HydrogreenPollub/fuel-cell-pcb/schematic-main.jpg

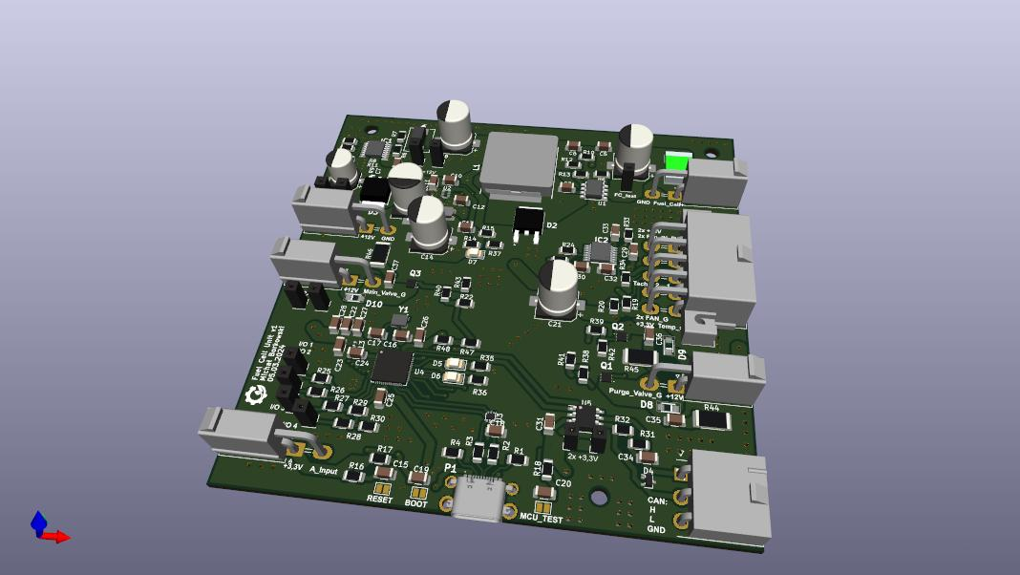
schematic-main.jpg
