HydrogreenPollub/fuel-cell-pcb/schematic-main 2.jpg

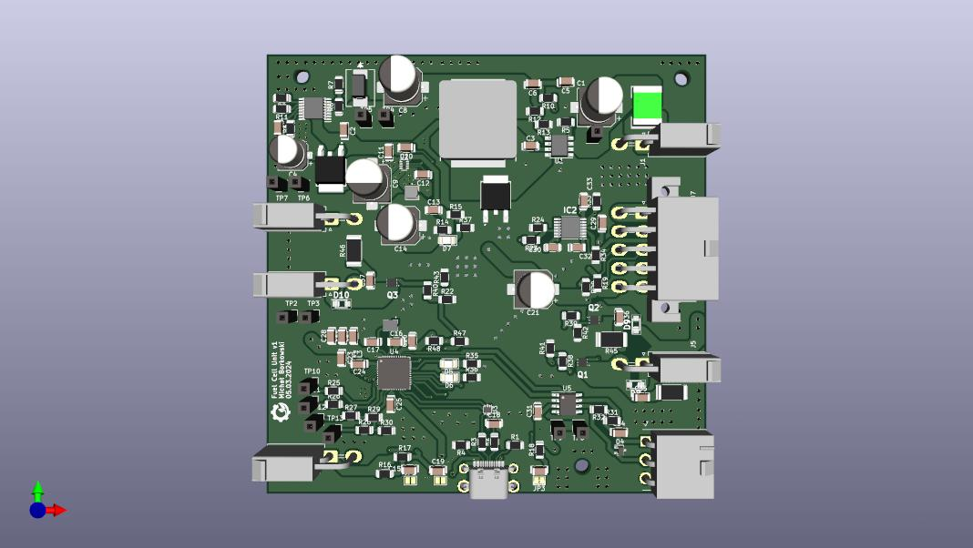
schematic-main 2.jpg
