HydrogreenPollub/fuel-cell-pcb/README.md

## Fuel cell control unit PCB

CADLAB preview: [link](https://cadlab.io/project/27518)
