HydrogreenPollub/fuel-cell-pcb/schematic-main.xlsx

Id | Oznaczenie | Footprint | Liczba | Oznaczenie | Dostawca i numer artykuĹ‚u
1 | C7 | C_1206_3216Metric | 1 | 2n7
2 | R41,R17,R15,R43,R20,R47,R23,R22,R42,R33,R19,R48,R18,R16,R30,R29 | R_1206_3216Metric | 16 | 10k
3 | JP3,JP2,JP1 | SolderJumper-2_P1.3mm_Open_Pad1.0x1.5mm | 3 | SolderJumper_2_Open
4 | TP9,TP8 | PinSocket_1x01_P2.54mm_Vertical | 2 | +3.3V
5 | R3,R2 | R_1206_3216Metric | 2 | 0
6 | C6 | C_1206_3216Metric | 1 | 3n3
7 | U2 | SOT-583-8 | 1 | TPS62933
8 | U5 | SOIC-8_3.9x4.9mm_P1.27mm | 1 | SN65HVD232
9 | R27,R28 | R_1206_3216Metric | 2 | 100R
10 | R46,R45,R44 | R_2512_6332Metric | 3 | 100R 0,5W
11 | J2 | Molex_Mini-Fit_Jr_5569-02A2_2x01_P4.20mm_Horizontal | 1 | Analog_In
12 | C28 | C_1206_3216Metric | 1 | 10n
13 | C16,C17 | C_1206_3216Metric | 2 | 12p
14 | R8,R9,R5 | R_1206_3216Metric | 3 | 100k
15 | C27,C15,C19,C20,C22,C2 | C_1206_3216Metric | 6 | 1u
16 | TP7,TP6 | PinSocket_1x01_P2.54mm_Vertical | 2 | +5V
17 | D8,D10,D9 | PMEG10020ELR | 3 | PMEG10020
18 | R24 | R_1206_3216Metric | 1 | 150k
19 | R26,R35,R37,R36,R25 | R_1206_3216Metric | 5 | 1k
20 | L3 | L_0402_1005Metric | 1 | 2n
21 | J1 | Molex_Mini-Fit_Jr_5569-02A2_2x01_P4.20mm_Horizontal | 1 | Fell_Cell_IN
22 | TP1 | PinSocket_1x01_P2.54mm_Vertical | 1 | I/O 1
23 | L2 | SRN3015TA4R7M | 1 | 4u7
24 | C23,C29,C25,C11,C26,C31,C12,C18,C24 | C_1206_3216Metric | 9 | 100n
25 | F1 | FUSC8664X180N | 1 | 3A
26 | R40,R38,R39 | R_1206_3216Metric | 3 | 180R
27 | C8 | CP_Elec_8x10.5 | 1 | 22u
28 | J4 | Molex_Mini-Fit_Jr_5569-02A2_2x01_P4.20mm_Horizontal | 1 | Axilary_Out
29 | Q2,Q1,Q3 | PMPB15XPAX | 3 | PMPB10XNX
30 | C9,C21,C1 | CP_Elec_8x10.5 | 3 | 10u
31 | IC2 | SOP65P640X120-14N | 1 | AD8544ARUZ-REEL
32 | TP13 | PinSocket_1x01_P2.54mm_Vertical | 1 | I/O 4
33 | D1 | TPSMCSeries_LTF | 1 | TPSMC30CA
34 | R11 | R_1206_3216Metric | 1 | 56k
35 | L1 | IHLP6767DZER470M11 | 1 | IHLP6767DZER470M11
36 | R34 | R_1206_3216Metric | 1 | 560k
37 | D7 POWER 3.3V,D5 CAN,D6 MCU | LED_1206_3216Metric | 3 | LED
38 | Y1 | KC3225K400000C1GE00 | 1 | Crystal_GND24
39 | U1 | Diodes_SO-8EP | 1 | LM5013DDAR
40 | TP5,TP4 | PinSocket_1x01_P2.54mm_Vertical | 2 | +12V
41 | R13 | R_1206_3216Metric | 1 | 49k9
42 | C3 | C_1206_3216Metric | 1 | 2n2
43 | TP1 | PinSocket_1x01_P2.54mm_Vertical | 1 | FC test
44 | J5 | Molex_Mini-Fit_Jr_5569-02A2_2x01_P4.20mm_Horizontal | 1 | P_Valve
45 | R14 | R_1206_3216Metric | 1 | 32k
46 | C5,C13 | C_1206_3216Metric | 2 | 47p
47 | C4 | CP_Elec_6.3x7.7 | 1 | 47u
48 | J6 | Molex_Mini-Fit_Jr_5569-02A2_2x01_P4.20mm_Horizontal | 1 | Valve
49 | IC1 | SOP65P640X120-17N | 1 | LM76202QPWPRQ1
50 | C34,C33,C30,C32 | C_1206_3216Metric | 4 | 4n7
51 | TP3,TP2 | PinSocket_1x01_P2.54mm_Vertical | 2 | GND
52 | D4 | SOT-323_SC-70 | 1 | SP0502BAJT
53 | C10 | C_1206_3216Metric | 1 | 33n
54 | C14 | CP_Elec_8x10.5 | 1 | 100u
55 | C36,C35,C37 | C_1206_3216Metric | 3 | 20n
56 | P1 | 2169900002 | 1 | USB_C_Plug_USB2.0
57 | R32,R31 | R_1206_3216Metric | 2 | 60
58 | J3 | 39303035 | 1 | CAN
59 | R6 | R_1206_3216Metric | 1 | 180k
60 | J7 | Molex_Mini-Fit_Jr_5569-10A1_2x05_P4.20mm_Horizontal | 1 | FC Cooling
61 | D2,D3 | TO252_(DPAK)_1 | 2 | MBRD20100CT-13
62 | R4,R1 | R_1206_3216Metric | 2 | 5k1
63 | R12 | R_1206_3216Metric | 1 | 453k
64 | R7 | R_1206_3216Metric | 1 | 12k
65 | U3 | SOT-666 | 1 | USBLC6-2P6
66 | TP2 | PinSocket_1x01_P2.54mm_Vertical | 1 | I/O 2
67 | R10 | R_1206_3216Metric | 1 | 143k
68 | TP12 | PinSocket_1x01_P2.54mm_Vertical | 1 | I/O 3
69 | U4 | QFN-56-1EP_7x7mm_P0.4mm_EP5.6x5.6mm | 1 | ESP32-S3FN8
