HydrogreenPollub/fuel-cell-pcb/schematic-main.kicad_pcb

## KiCad design schematic-main.kicad_pcb (2024-03-30)

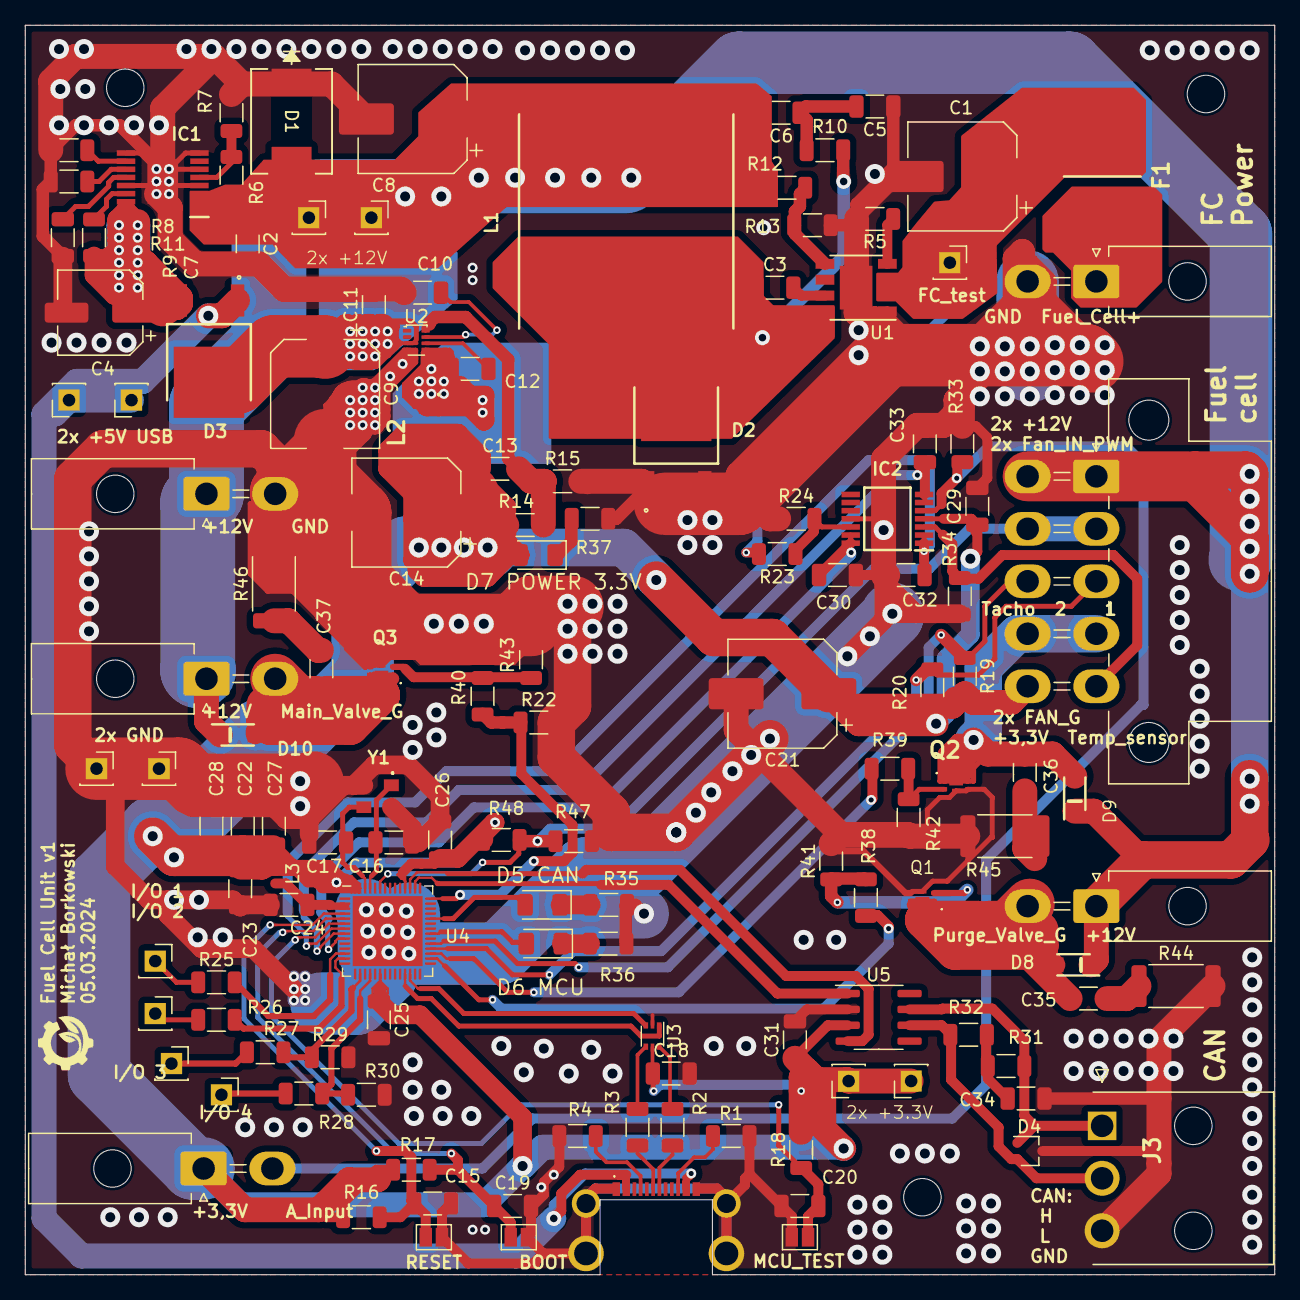
[picture p7: board schematic-main.kicad_pcb from above]

Board: 2 copper layers, 100.0 x 100.0 mm, 133 parts (0 on the bottom side), 73 nets.

Parts:
C1, C9, C21: 10u; CP_Elec_8x10.5
C2, C15, C19, C20, C22, C27: 1u; C_1206_3216Metric
C3: 2n2; C_1206_3216Metric
C4: 47u; CP_Elec_6.3x7.7
C5, C13: 47p; C_1206_3216Metric
C6: 3n3; C_1206_3216Metric
C7: 2n7; C_1206_3216Metric
C8: 22u; CP_Elec_8x10.5
C10: 33n; C_1206_3216Metric
C11, C12, C18, C23, C24, C25, C26, C29, C31: 100n; C_1206_3216Metric
C14: 100u; CP_Elec_8x10.5
C16, C17: 12p; C_1206_3216Metric
C28: 10n; C_1206_3216Metric
C30, C32, C33, C34: 4n7; C_1206_3216Metric
C35, C36, C37: 20n; C_1206_3216Metric
D1: TPSMC30CA; TPSMCSeries_LTF
D2, D3: MBRD20100CT-13; TO252_(DPAK)_1
D4: SP0502BAJT; SOT-323_SC-70
D5 CAN, D6 MCU, D7 POWER 3.3V: LED; LED_1206_3216Metric
D8, D9, D10: PMEG10020; PMEG10020ELR
F1: 3A; FUSC8664X180N
IC1: LM76202QPWPRQ1; SOP65P640X120-17N
IC2: AD8544ARUZ-REEL; SOP65P640X120-14N
J1: Fell_Cell_IN; Molex_Mini-Fit_Jr_5569-02A2_2x01_P4.20mm_Horizontal
J2: Analog_In; Molex_Mini-Fit_Jr_5569-02A2_2x01_P4.20mm_Horizontal
J3: CAN; 39303035
J4: Axilary_Out; Molex_Mini-Fit_Jr_5569-02A2_2x01_P4.20mm_Horizontal
J5: P_Valve; Molex_Mini-Fit_Jr_5569-02A2_2x01_P4.20mm_Horizontal
J6: Valve; Molex_Mini-Fit_Jr_5569-02A2_2x01_P4.20mm_Horizontal
J7: FC Cooling; Molex_Mini-Fit_Jr_5569-10A1_2x05_P4.20mm_Horizontal
JP1, JP2, JP3: SolderJumper_2_Open; SolderJumper-2_P1.3mm_Open_Pad1.0x1.5mm
L1: IHLP6767DZER470M11
L2: 4u7; SRN3015TA4R7M
L3: 2n; L_0402_1005Metric
P1: USB_C_Plug_USB2.0; 2169900002
Q1, Q2, Q3: PMPB10XNX; PMPB15XPAX
R1, R4: 5k1; R_1206_3216Metric
R2, R3: 0; R_1206_3216Metric
R5, R8, R9: 100k; R_1206_3216Metric
R6: 180k; R_1206_3216Metric
R7: 12k; R_1206_3216Metric
R10: 143k; R_1206_3216Metric
R11: 56k; R_1206_3216Metric
R12: 453k; R_1206_3216Metric
R13: 49k9; R_1206_3216Metric
R14: 32k; R_1206_3216Metric
R15, R16, R17, R18, R19, R20, R22, R23, R29, R30, R33, R41, R42, R43, R47, R48: 10k; R_1206_3216Metric
R24: 150k; R_1206_3216Metric
R25, R26, R35, R36, R37: 1k; R_1206_3216Metric
R27, R28: 100R; R_1206_3216Metric
R31, R32: 60; R_1206_3216Metric
R34: 560k; R_1206_3216Metric
R38, R39, R40: 180R; R_1206_3216Metric
R44, R45, R46: 100R 0,5W; R_2512_6332Metric
TP1: I/O 1; PinSocket_1x01_P2.54mm_Vertical
TP1#2: FC test; PinSocket_1x01_P2.54mm_Vertical
TP2: I/O 2; PinSocket_1x01_P2.54mm_Vertical
TP2#2, TP3: GND; PinSocket_1x01_P2.54mm_Vertical
TP4, TP5: +12V; PinSocket_1x01_P2.54mm_Vertical
TP6, TP7: +5V; PinSocket_1x01_P2.54mm_Vertical
TP8, TP9: +3.3V; PinSocket_1x01_P2.54mm_Vertical
TP12: I/O 3; PinSocket_1x01_P2.54mm_Vertical
TP13: I/O 4; PinSocket_1x01_P2.54mm_Vertical
U1: LM5013DDAR; Diodes_SO-8EP
U2: TPS62933; SOT-583-8
U3: USBLC6-2P6; SOT-666
U4: ESP32-S3FN8; QFN-56-1EP_7x7mm_P0.4mm_EP5.6x5.6mm
U5: SN65HVD232; SOIC-8_3.9x4.9mm_P1.27mm
Y1: Crystal_GND24; KC3225K400000C1GE00

Connections:
+3.3V: C13.1, C14.1, C18.1, C21.1, C22.1, C23.1, C25.1, C26.1, C27.1, C28.1, C29.1, C31.1, D7 POWER 3.3V.2 (A), IC2.4 (V+), J2.1, J7.10, L2.2, L3.1, R14.1, R16.2, R17.2, R18.2, R19.2, R20.2, R48.2, TP8.1, TP9.1, U3.5 (VBUS), U4.20 (VDD3P3_RTC), U4.46 (VDD3P3_CPU), U4.55 (VDDA), U4.56 (VDDA), U5.3 (VCC)
+5V: D3.1, P1.A4 (VBUS), P1.A9 (VBUS), P1.B4 (VBUS), P1.B9 (VBUS), TP6.1, TP7.1
+12V: C2.1, C6.2, C8.1, D1.2 (A), D8.1 (K), D9.1 (K), D10.1 (K), IC1.1 (IN_1), IC1.2 (IN_2), IC1.3 (UVLO), J4.1, J5.1, J6.1, J7.1, J7.6, L1.2, R6.1, R12.2, TP4.1, TP5.1
/IO/A_Input: IC2.5 (+IN_B), J2.2, R33.1
/IO/Analog_MCU: C33.1, IC2.6 (-IN_B), IC2.7 (OUT_B), U4.8 (GPIO3/ADC1_CH2)
/IO/CANH: D4.1 (K), J3.1, R31.2, U5.7 (CANH)
/IO/CANL: D4.2 (K), J3.2, R32.2, U5.6 (CANL)
/IO/CAN_RX: U4.44 (MTCK/JTAG/GPIO39), U5.1 (D)
/IO/CAN_TX: U4.45 (MTDO/JTAG/GPIO40), U5.4 (R)
/IO/FAN_1_TACHO: J7.3, R20.1, U4.32 (SPICS0/GPIO29)
/IO/FAN_2_TACHO: J7.8, R19.1, U4.33 (SPICLK/GPIO30)
/IO/FAN_GND: C36.1, D9.2 (A), J7.4, J7.9, Q2.1 (D)
/IO/FAN_IN_PWM: J7.2, J7.7, R47.1, R48.1, U4.51 (GPIO45)
/IO/FAN_ON_MCU: R39.2, U4.31 (SPIWP/GPIO28)
/IO/FC_V: C1.1, F1.2, R23.2, TP1#2.1, U1.2 (VIN), U1.3 (EN_UVLO)
/IO/FC_Voltage_MCU: C30.2, IC2.13 (-IN_D), IC2.14 (OUT_D), U4.9 (GPIO4/ADC1_CH3)
/IO/I/O_1_MCU: R25.2, U4.12 (GPIO7/ADC1_CH6)
/IO/I/O_2_MCU: R26.2, U4.13 (GPIO8/ADC1_CH7)
/IO/I/O_3_MCU: R27.2, R29.1, U4.16 (GPIO11/ADC2_CH0)
/IO/I/O_4_MCU: R28.2, R30.1, U4.18 (GPIO13/ADC2_CH2)
/IO/LED_CAN_STATUS: D5 CAN.2 (A), U4.38 (GPIO33)
/IO/LED_MCU_STATUS: D6 MCU.2 (A), U4.35 (SPID/GPIO32)
/IO/Main_Valve: C37.1, D10.2 (A), J6.2, Q3.1 (D)
/IO/Main_Valve_MCU: R22.1, R40.2, U4.42 (GPIO37)
/IO/PURGE_VALVE: C35.1, D8.2 (A), J5.2, Q1.1 (D)
/IO/PURGE_VALVE_MCU: R38.2, U4.30 (SPIHD/GPIO27)
/IO/Temp_MCU: C32.2, IC2.1 (OUT_A), IC2.2 (-IN_A), U4.7 (GPIO2/ADC1_CH1)
/IO/Temp_sensor: IC2.3 (+IN_A), J7.5, R34.1
/MCU/BOOT: C19.1, JP2.1 (A), R17.1, U4.5 (GPIO0/BOOT)
/MCU/MCU_TEST: C20.1, JP3.1 (A), R18.1, U4.6 (GPIO1/ADC1_CH0)
/MCU/RESET: C15.1, JP1.1 (A), R16.1, U4.4 (CHIP_PU/RESET)
/MCU/USB_D+: R3.2, U3.3 (I/O2), U3.4 (I/O2), U4.26 (GPIO20/USB_D+/ADC2_CH9)
/MCU/USB_D-: R2.2, U3.1 (I/O1), U3.6 (I/O1), U4.25 (GPIO19/USB_D-/ADC2_CH8)
/MCU/XTAL_N: C16.1, U4.53 (XTAL_N), Y1.1
/MCU/XTAL_P: C17.1, U4.54 (XTAL_P), Y1.3
/Power /FB_12: R12.1, R13.2, U1.5 (FB)
/Power /Vin: F1.1, J1.1
/Power /Vreg: C4.1, D3.2, IC1.15 (OUT_1), IC1.16 (OUT_2), R9.1
GND: C1.2, C2.2, C4.2, C5.1, C7.2, C8.2, C9.2, C10.2, C11.2, C14.2, C15.2, C16.2, C17.2, C18.2, C19.2, C20.2, C21.2, C22.2, C23.2, C24.2, C25.2, C26.2, C27.2, C28.2, C29.2, C30.1, C31.2, C32.1, C33.2, C34.2, D1.1 (K), D2.1 (A_1), D2.2 (A_2), D4.3 (A), IC1.4 (NC_1), IC1.6 (MODE), IC1.8 (RTN), IC1.9 (GND), IC1.13 (NC_2), IC1.17 (EP), IC2.11 (GND), J1.2, J3.3, J4.2, JP1.2 (B), JP2.2 (B), JP3.2 (B), P1.A1 (GND), P1.A12 (GND), P1.B1 (GND), P1.B12 (GND), Q1.3 (S), Q2.3 (S), Q3.3 (S), R1.2, R4.2, R5.2, R7.2, R8.2, R11.2, R13.1, R15.2, R22.2, R24.1, R29.2, R30.2, R33.2, R34.2, R35.2, R36.2, R37.2, R41.2, R42.2, R43.2, R44.2, R45.2, R46.2, R47.2, TP2#2.1, TP3.1, U1.1 (GND), U1.9 (EP), U2.4 (GND), U3.2 (GND), U4.57 (GND), U5.2 (GND), Y1.2, Y1.4
unnamed: C5.2, C6.1, R10.2
unnamed: C34.1, R31.1, R32.1
unnamed: C35.2, R44.1
unnamed: C36.2, R45.1
unnamed: C37.2, R46.1
unnamed: C3.1, D2.3 (K), L1.1, R10.1, U1.8 (SW)
unnamed: D5 CAN.1 (K), R35.1
unnamed: D6 MCU.1 (K), R36.1
unnamed: D7 POWER 3.3V.1 (K), R37.1
unnamed: C7.1, IC1.12 (DVDT)
unnamed: IC1.11 (ILIM), R11.1
unnamed: IC1.10 (IMON), R8.1
unnamed: IC1.5 (OVP), R6.2, R7.1
unnamed: IC1.14 (~FLT), R9.2
unnamed: IC2.12 (+IN_D), R23.1, R24.2
unnamed: P1.A5 (CC), R4.1
unnamed: P1.A6 (D+), R3.1
unnamed: P1.A7 (D-), R2.1
unnamed: P1.B5 (VCONN), R1.1
unnamed: Q1.2 (G), R38.1, R41.1
unnamed: Q2.2 (G), R39.1, R42.1
unnamed: Q3.2 (G), R40.1, R43.1
unnamed: R25.1, TP1.1
unnamed: R26.1, TP2.1
unnamed: R27.1, TP12.1
unnamed: R28.1, TP13.1
unnamed: C3.2, U1.7 (BST)
unnamed: R5.1, U1.4 (RON)
unnamed: C12.1, U2.6 (BST)
unnamed: C13.2, R14.2, R15.1, U2.8 (FB)
unnamed: C10.1, U2.7 (SS)
unnamed: C12.2, L2.1, U2.5 (SW)
unnamed: C9.1, C11.1, D3.3, U2.3 (VIN)
VDD3P3: C24.1, L3.2, U4.2 (VDD3P3), U4.3 (VDD3P3)
