HydrogreenPollub/fuel-cell-pcb/OLDschematic-main.kicad_pcb

## KiCad design OLDschematic-main.kicad_pcb (2024-01-26)

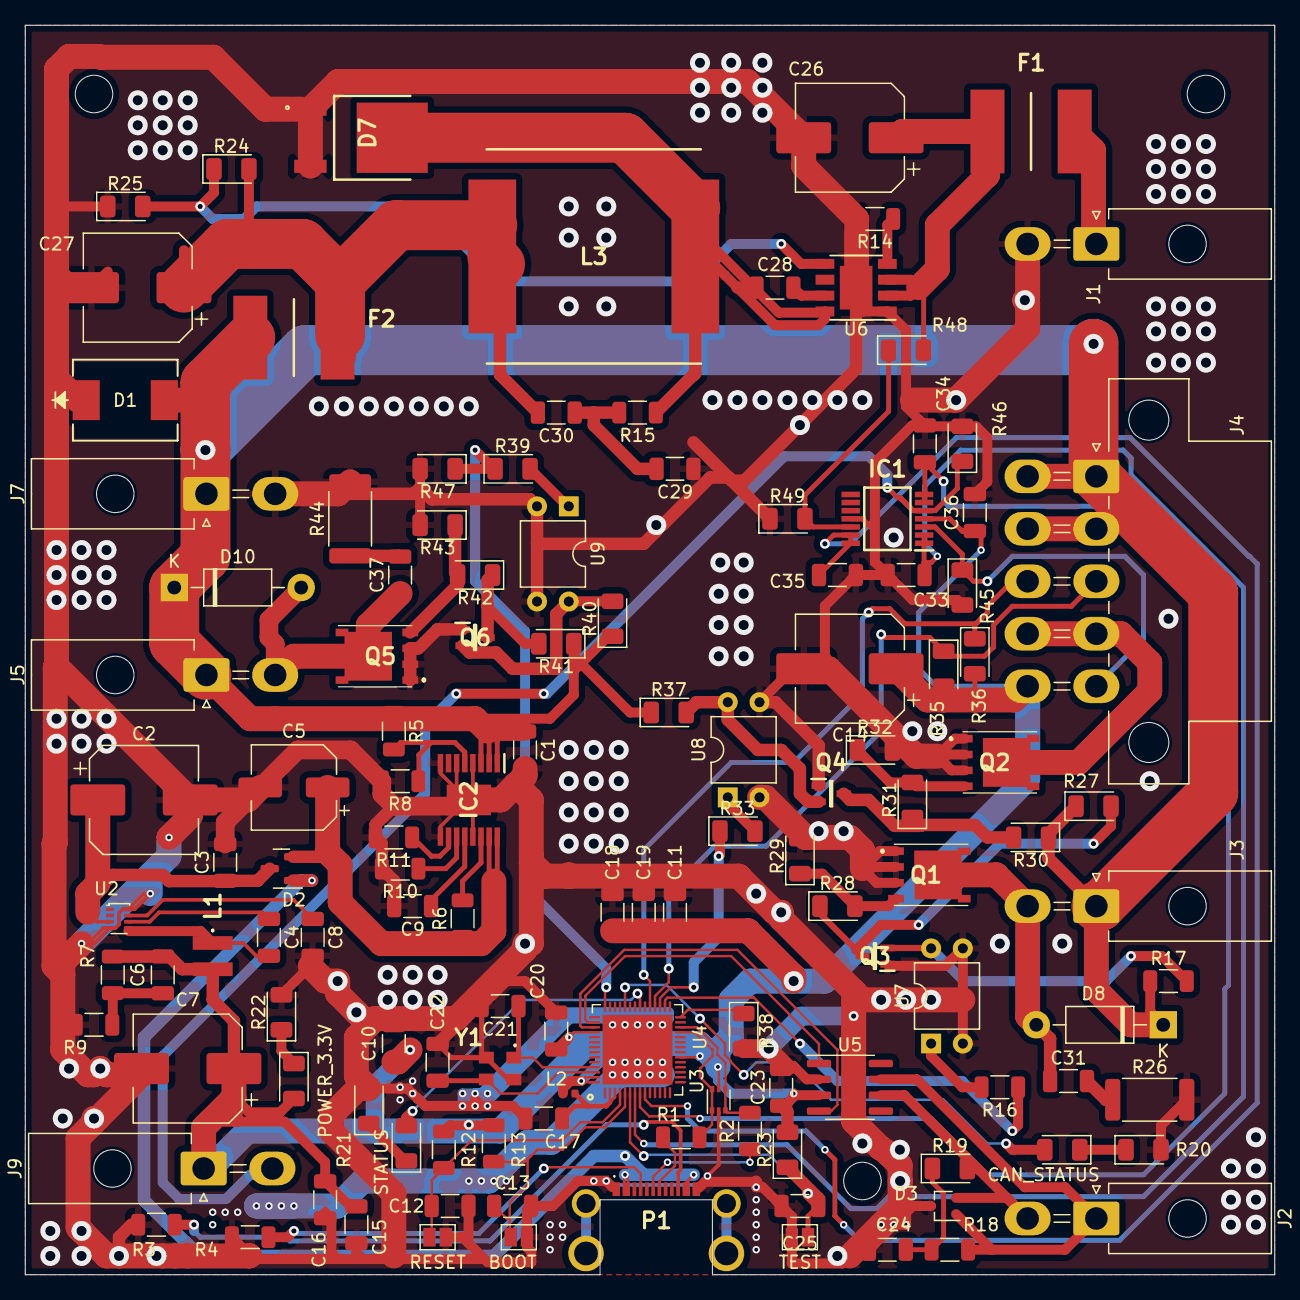
[picture p8: board OLDschematic-main.kicad_pcb from above]

Board: 2 copper layers, 100.0 x 100.0 mm, 126 parts (0 on the bottom side), 75 nets.

Parts:
BOOT: SolderJumper_2_Open; SolderJumper-2_P1.3mm_Open_Pad1.0x1.5mm
C1, C12, C13, C15, C18, C25: 1u; C_1206_3216Metric
C2, C14, C26: 10u; CP_Elec_8x10.5
C3, C4, C10, C11, C16, C17, C20, C23, C36: 100n; C_1206_3216Metric
C5: 47u; CP_Elec_6.3x7.7
C6, C29: 47p; C_1206_3216Metric
C7: 100u; CP_Elec_8x10.5
C8: 33n; C_1206_3216Metric
C9: 2n7; C_1206_3216Metric
C19: 10n; C_1206_3216Metric
C21, C22: 12p; C_1206_3216Metric
C24, C33, C34, C35: 4n7; C_1206_3216Metric
C27: 22u; CP_Elec_8x10.5
C28: 2n2; C_1206_3216Metric
C30: 3n3; C_1206_3216Metric
C31, C37: 20n; C_1206_3216Metric
CAN_STATUS: LED; D_1206_3216Metric
D1: TPSMC30CA; TPSMCSeries_LTF
D2: BAS40-05; SOT-23
D3: SP0502BAJT; SOT-323_SC-70
D7: MBRD20100CT-13; TO252_(DPAK)_1
D8, D10: 1N5819; D_DO-41_SOD81_P10.16mm_Horizontal
F1, F2: 3A; FUSC8664X180N
IC1: AD8544ARUZ-REEL; SOP65P640X120-14N
IC2: LM76202QPWPRQ1; SOP65P640X120-17N
J1: Fell_Cell_IN; Molex_Mini-Fit_Jr_5569-02A2_2x01_P4.20mm_Horizontal
J2: CAN; Molex_Mini-Fit_Jr_5569-02A2_2x01_P4.20mm_Horizontal
J3: P_Valve; Molex_Mini-Fit_Jr_5569-02A2_2x01_P4.20mm_Horizontal
J4: FC Cooling; Molex_Mini-Fit_Jr_5569-10A1_2x05_P4.20mm_Horizontal
J5: Valve; Molex_Mini-Fit_Jr_5569-02A2_2x01_P4.20mm_Horizontal
J7: Axilary_Out; Molex_Mini-Fit_Jr_5569-02A2_2x01_P4.20mm_Horizontal
J9: Analog_In; Molex_Mini-Fit_Jr_5569-02A2_2x01_P4.20mm_Horizontal
L1: 4u7; SRN3015TA4R7M
L2: 2n; L_0402_1005Metric
L3: IHLP6767DZER470M11
P1: USB_C_Plug_USB2.0; 2169900002
POWER_3.3V: LED; D_1206_3216Metric
Q1, Q2, Q5: SIR186LDP-T1-RE3; SI7141DPT1GE3
Q3, Q4, Q6: 2N3904; SOT65P220X100-3N
R1, R2: 0; R_1206_3216Metric
R3, R4: 5k1; R_1206_3216Metric
R5: 180k; R_1206_3216Metric
R6, R11, R14: 100k; R_1206_3216Metric
R7: 32k; R_1206_3216Metric
R8: 12k; R_1206_3216Metric
R9, R12, R13: 10k; R_1206_3216Metric
R10: 56k; R_1206_3216Metric
R15: 143k; R_1206_3216Metric
R16: 100; R_1206_3216Metric
R17: 1k; R_1206_3216Metric
R18: 60; R_1206_3216Metric
R19: 60; LED_1206_3216Metric
R20, R21, R22, R27, R30, R37, R40, R41: 1k; LED_1206_3216Metric
R23, R29, R32, R35, R36, R38, R43, R46, R47, R48: 10k; LED_1206_3216Metric
R24: 453k; LED_1206_3216Metric
R25: 49k9; LED_1206_3216Metric
R26, R44: 100R 0,5W; R_2512_6332Metric
R28, R31, R33, R39, R42: 100; LED_1206_3216Metric
R45: 560k; LED_1206_3216Metric
R49: 150k; LED_1206_3216Metric
RESET: SolderJumper_2_Open; SolderJumper-2_P1.3mm_Open_Pad1.0x1.5mm
STATUS: LED; D_1206_3216Metric
TEST: SolderJumper_2_Open; SolderJumper-2_P1.3mm_Open_Pad1.0x1.5mm
U2: TPS62933; SOT-583-8
U3: USBLC6-2P6; SOT-666
U4: ESP32-S3FN8; QFN-56-1EP_7x7mm_P0.4mm_EP5.6x5.6mm
U5: SN65HVD232; SOIC-8_3.9x4.9mm_P1.27mm
U6: LM5013DDAR; Diodes_SO-8EP
U7, U8, U9: PC817; DIP-4_W7.62mm
Y1: Crystal_GND24; KC3225K400000C1GE00

Connections:
+3.3V: C6.1, C7.1, C10.1, C11.1, C14.1, C15.1, C16.1, C18.1, C19.1, C20.1, C23.1, C36.1, IC1.4 (V+), J4.10, J9.1, L1.2, L2.1, POWER_3.3V.2 (A), R7.1, R12.2, R13.2, R23.2, R35.2, R36.2, U3.5 (VBUS), U4.20 (VDD3P3_RTC), U4.46 (VDD3P3_CPU), U4.55 (VDDA), U4.56 (VDDA), U5.3 (VCC)
+12V: C1.1, D1.2 (A), D8.1 (K), D10.1 (K), F2.2, IC2.1 (IN_1), IC2.2 (IN_2), IC2.3 (UVLO), J3.1, J4.1, J4.6, J5.1, J7.1, R5.1, R17.1, R27.1, R30.1, R37.1, R40.1, R41.1
/FAN_PWM: J4.2, J4.7
/IO/A_Input: IC1.5 (+IN_B), J9.2, R46.1
/IO/Analog_MCU: C34.1, IC1.6 (-IN_B), IC1.7 (OUT_B), U4.8 (GPIO3/ADC1_CH2)
/IO/CANH: D3.1 (K), J2.1, R18.2, U5.7 (CANH)
/IO/CANL: D3.2 (K), J2.2, R19.2, U5.6 (CANL)
/IO/CAN_RX: U4.44 (MTCK/JTAG/GPIO39), U5.1 (D)
/IO/CAN_TX: U4.45 (MTDO/JTAG/GPIO40), U5.4 (R)
/IO/FAN_1_TACHO: J4.3, R35.1, U4.32 (SPICS0/GPIO29)
/IO/FAN_2_TACHO: J4.8, R36.1, U4.33 (SPICLK/GPIO30)
/IO/FAN_GND: J4.4, J4.9, Q2.5 (D_1), Q2.6 (D_2), Q2.7 (D_3), Q2.8 (D_4), Q2.9 (D_5), Q2.10 (D_6), Q2.11 (D_7)
/IO/FAN_ON_MCU: R33.1, U4.31 (SPIWP/GPIO28)
/IO/FC_Voltage_MCU: C35.2, IC1.13 (-IN_D), IC1.14 (OUT_D), U4.9 (GPIO4/ADC1_CH3)
/IO/LED_CAN_STATUS: CAN_STATUS.2 (A), U4.38 (GPIO33)
/IO/LED_MCU_STATUS: STATUS.2 (A), U4.35 (SPID/GPIO32)
/IO/Main_Valve: C37.1, D10.2 (A), J5.2, Q5.5 (D_1), Q5.6 (D_2), Q5.7 (D_3), Q5.8 (D_4), Q5.9 (D_5), Q5.10 (D_6), Q5.11 (D_7)
/IO/Main_Valve_MCU: R39.1, R47.1, U4.42 (GPIO37)
/IO/PURGE_VALVE: C31.1, D8.2 (A), J3.2, Q1.5 (D_1), Q1.6 (D_2), Q1.7 (D_3), Q1.8 (D_4), Q1.9 (D_5), Q1.10 (D_6), Q1.11 (D_7)
/IO/PURGE_VALVE_MCU: R16.1, U4.30 (SPIHD/GPIO27)
/IO/SC_V: C26.1, F1.2, R48.2, U6.2 (VIN), U6.3 (EN_UVLO)
/IO/Temp_MCU: C33.2, IC1.1 (OUT_A), IC1.2 (-IN_A), U4.7 (GPIO2/ADC1_CH1)
/IO/Temp_sensor: IC1.3 (+IN_A), J4.5, R45.1
/MCU/BOOT: BOOT.1 (A), C13.1, R13.1, U4.5 (GPIO0/BOOT)
/MCU/FAN_PWM_MCU: R38.1, U4.28 (SPI_CS1/GPIO26)
/MCU/MCU_TEST: C25.1, R23.1, TEST.1 (A), U4.6 (GPIO1/ADC1_CH0)
/MCU/RESET: C12.1, R12.1, RESET.1 (A), U4.4 (CHIP_PU/RESET)
/MCU/USB_D+: R2.2, U3.3 (I/O2), U3.4 (I/O2), U4.26 (GPIO20/USB_D+/ADC2_CH9)
/MCU/USB_D-: R1.2, U3.1 (I/O1), U3.6 (I/O1), U4.25 (GPIO19/USB_D-/ADC2_CH8)
/MCU/XTAL_N: C21.1, U4.53 (XTAL_N), Y1.1
/MCU/XTAL_P: C22.1, U4.54 (XTAL_P), Y1.3
/Power /FB_12: R24.1, R25.2, U6.5 (FB)
/Power /Vin: F1.1, J1.1
/Power /Vreg: C5.1, D2.2, IC2.15 (OUT_1), IC2.16 (OUT_2), R6.1
/VBUS: D2.1, P1.A4 (VBUS), P1.A9 (VBUS), P1.B4 (VBUS), P1.B9 (VBUS)
GND: BOOT.2 (B), C1.2, C2.2, C3.2, C5.2, C7.2, C8.2, C9.2, C10.2, C11.2, C12.2, C13.2, C14.2, C15.2, C16.2, C17.2, C18.2, C19.2, C20.2, C21.2, C22.2, C23.2, C24.2, C25.2, C26.2, C27.2, C29.1, C33.1, C34.2, C35.1, C36.2, D1.1 (K), D3.3 (A), D7.1 (A_1), D7.2 (A_2), IC1.11 (V-), IC2.4 (NC_1), IC2.6 (MODE), IC2.8 (RTN), IC2.9 (GND), IC2.13 (NC_2), IC2.17 (EP), J1.2, J7.2, P1.A1 (GND), P1.A12 (GND), P1.B1 (GND), P1.B12 (GND), Q1.1 (S_1), Q1.2 (S_2), Q1.3 (S_3), Q2.1 (S_1), Q2.2 (S_2), Q2.3 (S_3), Q3.1 (E), Q4.1 (E), Q5.1 (S_1), Q5.2 (S_2), Q5.3 (S_3), Q6.1 (E), R3.2, R4.2, R8.2, R9.2, R10.2, R11.2, R14.2, R20.2, R21.2, R22.2, R25.1, R26.2, R29.2, R32.2, R38.2, R43.2, R44.2, R45.2, R46.2, R47.2, R49.1, RESET.2 (B), TEST.2 (B), U2.4 (GND), U2.8 (FB), U3.2 (GND), U4.57 (GND), U5.2 (GND), U6.1 (GND), U6.9 (EP), U7.2, U7.3, U8.2, U8.3, U9.2, U9.3, Y1.2, Y1.4
unnamed: C24.1, R18.1, R19.1
unnamed: C27.1, C30.2, F2.1, L3.2, R24.2
unnamed: C29.2, C30.1, R15.2
unnamed: C31.2, R26.1
unnamed: C37.2, R44.1
unnamed: CAN_STATUS.1 (K), R20.1
unnamed: R21.1, STATUS.1 (K)
unnamed: POWER_3.3V.1 (K), R22.1
unnamed: C28.1, D7.3 (K), L3.1, R15.1, U6.8 (SW)
unnamed: IC1.12 (+IN_D), R48.1, R49.2
unnamed: C9.1, IC2.12 (DVDT)
unnamed: IC2.11 (ILIM), R10.1
unnamed: IC2.10 (IMON), R11.1
unnamed: IC2.5 (OVP), R5.2, R8.1
unnamed: IC2.14 (~FLT), R6.2
unnamed: P1.A5 (CC), R4.1
unnamed: P1.A6 (D+), R2.1
unnamed: P1.A7 (D-), R1.1
unnamed: P1.B5 (VCONN), R3.1
unnamed: Q1.4 (G), R28.2, R29.1
unnamed: Q2.4 (G), R31.2, R32.1
unnamed: Q3.2 (B), R17.2, U7.4
unnamed: Q3.3 (C), R27.2, R28.1
unnamed: Q4.2 (B), R37.2, U8.4
unnamed: Q4.3 (C), R30.2, R31.1
unnamed: Q5.4 (G), R42.2, R43.1
unnamed: Q6.2 (B), R40.2, U9.4
unnamed: Q6.3 (C), R41.2, R42.1
unnamed: R16.2, U7.1
unnamed: R33.2, U8.1
unnamed: R39.2, U9.1
unnamed: C4.1, U2.6 (BST)
unnamed: C6.2, R7.2, R9.1
unnamed: C8.1, U2.7 (SS)
unnamed: C4.2, L1.1, U2.5 (SW)
unnamed: C2.1, C3.1, D2.3, U2.3 (VIN)
unnamed: C28.2, U6.7 (BST)
unnamed: R14.1, U6.4 (RON)
VDD3P3: C17.1, L2.2, U4.2 (VDD3P3), U4.3 (VDD3P3)
