HydrogreenPollub/fuel-cell-pcb/(commit log)

2023-11-15 Update project structure to fit its name
    [schematc-io.kicad_sch, schematic-main.kicad_sch, schematic-mcu.kicad_sch, schematic-power.kicad_sch]
2023-11-21 Add power stages
    Valve, power supplay, fan
    [schematc-io.kicad_sch, schematic-main.kicad_sch, schematic-mcu.kicad_sch, schematic-power.kicad_sch]
2023-11-22 Add tags
    Edit main schema and sockets
    [schematc-io.kicad_sch, schematic-main.kicad_sch, schematic-power.kicad_sch]
2023-12-19 Add Schottky Diode for VBUS and Vreg
    [schematic-main.kicad_sch, schematic-mcu.kicad_sch, schematic-power.kicad_sch]
2024-01-24 Add FC voltage measure, axilary input and output
    Schematic complet?
    [schematc-io.kicad_sch, schematic-main.kicad_sch, schematic-mcu.kicad_sch, schematic-power.kicad_sch]
2024-01-24 First pcb, change fan conector
    [schematc-io.kicad_sch, schematic-main.kicad_pcb, schematic-main.kicad_sch, schematic-mcu.kicad_sch, schematic-power.kicad_sch]
2024-01-25 Change FC connector to 10pin & ideal diode sircuit
    [schematc-io.kicad_sch, schematic-main.kicad_pcb, schematic-main.kicad_sch, schematic-mcu.kicad_sch, schematic-power.kicad_sch]
2024-01-26 Complate frist version
    [schematc-io.kicad_sch, schematic-main.kicad_pcb, schematic-main.kicad_sch, schematic-mcu.kicad_sch, schematic-power.kicad_sch]
2024-01-30 porawa library
    [schematc-io.kicad_sch, schematic-main.kicad_sch]
2024-02-07 Edit main
    [schematc-io.kicad_sch, schematic-main.kicad_sch, schematic-power.kicad_sch]
2024-02-10 Valve driver
    [schematc-io.kicad_sch]
2024-02-26 New pcb 1
    [OLDschematic-main.kicad_pcb, schematc-io.kicad_sch, schematic-main.kicad_pcb, schematic-main.kicad_sch, schematic-mcu.kicad_sch, schematic-power.kicad_sch]
2024-02-26 Power stage pcb complate
    [schematc-io.kicad_sch, schematic-main.kicad_pcb, schematic-main.kicad_sch, schematic-mcu.kicad_sch, schematic-power.kicad_sch]
2024-03-02 New pcb 2
    Near complate
    [schematc-io.kicad_sch, schematic-main.kicad_pcb, schematic-main.kicad_sch, schematic-mcu.kicad_sch]
2024-03-05 New pcb 3
    Full connections and logotypes
    [schematc-io.kicad_sch, schematic-main.kicad_pcb, schematic-main.kicad_sch, schematic-mcu.kicad_sch, schematic-power.kicad_sch]
2024-03-10 New pcb 4
    [schematic-main.kicad_pcb]
2024-03-12 New pcb 5
    [schematic-main-B_Cu.gbr, schematic-main-B_Mask.gbr, schematic-main-B_Paste.gbr, schematic-main-B_Silkscreen.gbr, schematic-main-Edge_Cuts.gbr, schematic-main-F_Cu.gbr, schematic-main-F_Mask.gbr, schematic-main-F_Paste.gbr]
2024-03-23 New pcb 6 end
    [FCU-model.cfg, schematic-main.kicad_pcb]
2024-03-30 DRC tested
    [FCCU-model.cfg, FCU-model.cfg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]
2024-03-30 Stencil 4x pcb
    [pcb.kicad_pcb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]
2024-04-05 Rename and send to production
    [pcb_schematic_main_FCCU.kicad_pcb]
